dsorensen228/sherman/docs/decisions/README.md

# Architecture Decision Records

Create `NNNN-short-title.md` using the sections: Status, Context, Decision, Alternatives, Consequences, Verification, Rollback, and Links. Status is Proposed, Accepted, Superseded, or Rejected.

An ADR is required for language/runtime changes, safety authority, wire formats, storage engines, OS baselines, display/electrical architecture, exact motor/battery family, chassis envelope freeze, privacy defaults, and any decision that changes multiple owned areas.

Accepted decisions:

- `0001-permanent-luckfox-dev-board.md`
- `0002-expiring-motion-authority.md`
- `0004-zero-touch-charging-and-autonomous-dock.md`
- `0005-dedicated-charge-interlock-pcb.md`
- `0006-generated-idle-banter.md`
- `0007-manual-banter-trigger.md`
- `0008-manual-banter-during-circadian-quiet.md`

Proposed decisions under qualification:

- `0003-landscape-spi-face-display.md`
- `0009-pico-controller-draft.md` — W1 diagnostic firmware and controller protocol;
  physical motion qualification remains open.
