dsorensen228/sherman/assets/concept/PROMPTS.md

# Concept Image Prompts

Generated with the built-in ImageGen path on 2026-08-06. These are product-intent references, not dimensionally accurate designs.

## `sherman-final-product-render.png`

```text
Use case: stylized-concept
Asset type: final product industrial-design hero render for Project Sherman
Primary request: Create a highly polished artistic render of Sherman, a tiny autonomous desktop exploration robot, as a believable finished product.
Scene/backdrop: clean warm-gray industrial design studio sweep, subtle ground plane only.
Subject: a palm-sized robot approximately 70 mm long, 60 mm wide, and 45 mm tall. Rounded pebble-like ivory polycarbonate shell with a charcoal lower chassis. Two small rubber wheels are partially recessed at the left and right rear quarters; a tiny hidden support skid is barely visible. The front face is a glossy black rectangular display window showing two simple expressive cyan-white animated eyes, curious and friendly, no mouth. Below and between the eyes, integrate one very small camera aperture and discreet time-of-flight sensor windows without making it look like a surveillance camera. Include subtle ventilation and a service seam. No arms, antenna, exposed circuit boards, tank treads, logos, or text.
Style/medium: premium photorealistic product visualization with credible injection-molded surfaces and functional compact robotics detailing; cute through proportion and eye expression, not toy-like decoration.
Composition/framing: three-quarter front view at desk level, entire robot visible, generous margin, slight scale cues but no other objects.
Lighting/mood: soft studio key light, delicate rim, grounded shadow, optimistic and quietly capable.
Color palette: warm ivory, graphite, muted teal/cyan eyes, minimal red/orange emergency accent only if needed.
Materials/textures: fine matte shell, satin chassis, realistic rubber tires, anti-reflective glass display.
Constraints: physically plausible compact differential-drive robot; low center of gravity; camera and sensors must not dominate the face; product should feel serviceable and buildable around a development board; no text, no watermark.
Avoid: humanoid body, legs, arms, ears, pet styling, glossy toy plastic, oversized wheels, exposed electronics, impossible floating parts, aggressive military styling, branded marks.
```

## `sherman-desk-context.png`

```text
Use case: stylized-concept
Asset type: Project Sherman desk-context concept art
Primary request: Show the same final Sherman robot concept in use on a real adult work desk, emphasizing tiny scale, autonomy, and personality.
Scene/backdrop: tasteful lived-in home-office desk with keyboard edge, ceramic coffee mug, notebook, monitor stand, and a few cables; everything orderly enough to read clearly.
Subject: Sherman is a palm-sized autonomous differential-drive robot, approximately 70 mm long, 60 mm wide, 45 mm tall. Rounded ivory pebble shell, charcoal lower chassis, two partially recessed rubber wheels, glossy black front display with two simple cyan-white expressive eyes, one tiny camera aperture and discreet time-of-flight windows. He is paused beside the coffee mug, looking up at it with curious slightly narrowed eyes as if investigating a newly moved object. No mouth, arms, antenna, legs, ears, or logos.
Style/medium: cinematic but believable high-end product lifestyle photography / photorealistic industrial design visualization.
Composition/framing: wide three-quarter desk-level view with Sherman fully visible and clearly much smaller than the mug and keyboard; enough negative space to feel like a product story image.
Lighting/mood: warm morning window light, gentle monitor fill, charming and quietly humorous, realistic grounded shadows.
Color palette: warm neutral office, ivory and graphite robot, subtle cyan eye light.
Materials/textures: realistic molded polycarbonate, anti-reflective display glass, rubber wheels, wood or matte laminate desktop.
Constraints: preserve a physically plausible compact wheeled robot design; show no docking station; no text or watermark; camera is subtle and not threatening.
Avoid: toy-scale fake miniature look, humanoid robot, pet costume, oversized eyes protruding from body, exposed electronics, futuristic spaceship desk, clutter hiding the robot, duplicate robot.
```

## Regeneration rules

- Preserve the front black display, ivory shell, graphite lower chassis, two-wheel differential-drive form, tiny sensor apertures, and palm-sized scale.
- Change only one design dimension per iteration and record it here.
- Do not use a render to close mechanical, optical, thermal, or ergonomic requirements.
