dsorensen228/sherman/electronics/prototype-netlist.csv

net | domain | source_endpoint | destination_endpoint | direction | wire | stage | status | notes
LCD_3V3 | 3.3V_LUCKFOX | Luckfox_P1_pin_1 | Waveshare_23822_VCC | power | existing | A | verified | Do not alter
LCD_GND | GND | Luckfox_P1_pin_25 | Waveshare_23822_GND | power | existing | A | verified | Do not alter
LCD_DC | 3.3V_LOGIC | Luckfox_P1_pin_13_GPIO1_D0 | Waveshare_23822_DC | Luckfox_to_LCD | existing | A | verified | gpiochip1_offset_24
LCD_RST_N | 3.3V_LOGIC | Luckfox_P1_pin_15_GPIO1_D1 | Waveshare_23822_RST | Luckfox_to_LCD | existing | A | verified | gpiochip1_offset_25
LCD_MOSI | 3.3V_LOGIC | Luckfox_P1_pin_19_SPI0_M0_MOSI | Waveshare_23822_DIN | Luckfox_to_LCD | existing | A | verified | No_MISO
LCD_CLK | 3.3V_LOGIC | Luckfox_P1_pin_23_SPI0_M0_CLK | Waveshare_23822_CLK | Luckfox_to_LCD | existing | A | verified | Deployed_40MHz
LCD_CS_N | 3.3V_LOGIC | Luckfox_P1_pin_24_SPI0_M0_CS0 | Waveshare_23822_CS | Luckfox_to_LCD | existing | A | verified | Active_low
LCD_BL | 3.3V_LOGIC | Luckfox_P1_pin_26_GPIO1_D2 | Waveshare_23822_BL | Luckfox_to_LCD | existing | A | verified | gpiochip1_offset_26
GND_UART | GND | Luckfox_P1_pin_9_GND | Pico2_pin_3_GND | power | logic | C | proposed | Connect_before_TX_RX
HOST_TX | 3.3V_LOGIC | Luckfox_P1_pin_11_GPIO1_B1_UART4_M0_TX | Pico2_pin_2_GP1_UART0_RX | Luckfox_to_Pico | logic | C | gated | Enable_only_uart4m0_xfer_and_verify_ttyS4_zero_boot_chatter
HOST_RX | 3.3V_LOGIC | Pico2_pin_1_GP0_UART0_TX | Luckfox_P1_pin_7_GPIO1_B0_UART4_M0_RX | Pico_to_Luckfox | logic | C | gated | Enable_only_uart4m0_xfer_and_verify_ttyS4_two_way
FRONT_3V3 | 3.3V_LUCKFOX | Luckfox_P1_pin_17 | Pololu_3417_VIN | power | logic | E | gated | Requires_150mA_measured_Luckfox_rail_headroom_and_never_connect_3417_VDD
FRONT_GND | GND | Luckfox_P1_pin_14 | Pololu_3417_GND | power | logic | E | gated | Front_rail_and_pinmux_gates_apply
FRONT_SCL | 3.3V_LOGIC | Luckfox_P1_pin_3_GPIO1_A0_I2C2_SCL_M0 | Pololu_3417_SCL | bidirectional | logic | E | gated | Open_drain_start_100kHz
FRONT_SDA | 3.3V_LOGIC | Luckfox_P1_pin_5_GPIO1_A1_I2C2_SDA_M0 | Pololu_3417_SDA | bidirectional | logic | E | gated | Default_address_0x29
FRONT_LPN_N | 3.3V_LOGIC | Luckfox_P1_pin_18_GPIO2_A6 | Pololu_3417_LPn | Luckfox_to_sensor | logic | E | gated | Drive_low_or_release_after_gpio2_a6_unclaimed_i2c3m0_inactive_proof
FRONT_INT_N | 3.3V_LOGIC | Pololu_3417_INT | Luckfox_P1_pin_12_GPIO1_C6 | sensor_to_Luckfox | logic | E | gated | Optional_open_drain_sensor_output_verify_pin_unclaimed
FRONT_I2C_RST | 3.3V_LOGIC | Luckfox_P1_pin_16_GPIO2_A7 | Pololu_3417_I2C_RST | Luckfox_to_sensor | logic | E | gated | Active_high_carrier_pulldown_after_gpio2_a7_unclaimed_i2c3m0_inactive_proof
3V3_PICO | 3.3V_PICO | Pico2_pin_36_3V3_OUT | Pololu_3692_left_VIN | power | logic | D | proposed | Bus_logic_equals_VIN
3V3_PICO | 3.3V_PICO | Pico2_pin_36_3V3_OUT | Pololu_3692_right_VIN | power | logic | D | proposed | Bus_logic_equals_VIN
3V3_PICO | 3.3V_PICO | Pico2_pin_36_3V3_OUT | Pololu_2798_VIN | power | logic | D | proposed | Bus_logic_equals_VIN
3V3_PICO | 3.3V_PICO | Pico2_pin_36_3V3_OUT | Adafruit_5580_VIN | power | logic | D | proposed | Gauge_chip_itself_requires_battery
3V3_PICO | 3.3V_PICO | Pico2_pin_36_3V3_OUT | Motor_left_4762_blue_encoder_Vcc | power | logic | F | gated | Encoder_supports_2.7V_to_18V
3V3_PICO | 3.3V_PICO | Pico2_pin_36_3V3_OUT | Motor_right_4762_blue_encoder_Vcc | power | logic | F | gated | Encoder_supports_2.7V_to_18V
GND_LOGIC | GND | Pico2_pin_8_GND | Pololu_3692_left_GND | power | logic | D | proposed | Common_Pico_ground
GND_LOGIC | GND | Pico2_pin_8_GND | Pololu_3692_right_GND | power | logic | D | proposed | Common_Pico_ground
GND_LOGIC | GND | Pico2_pin_8_GND | Pololu_2798_GND | power | logic | D | proposed | Common_Pico_ground
GND_LOGIC | GND | Pico2_pin_8_GND | Adafruit_5580_GND | power | logic | D | proposed | Common_Pico_ground
SAFE_SDA | 3.3V_LOGIC | Pico2_pin_6_GP4_I2C0_SDA | Pololu_3692_left_SDA | bidirectional | logic | D | proposed | Shared_bus
SAFE_SDA | 3.3V_LOGIC | Pico2_pin_6_GP4_I2C0_SDA | Pololu_3692_right_SDA | bidirectional | logic | D | proposed | Shared_bus
SAFE_SDA | 3.3V_LOGIC | Pico2_pin_6_GP4_I2C0_SDA | Pololu_2798_SDA | bidirectional | logic | D | proposed | Shared_bus
SAFE_SDA | 3.3V_LOGIC | Pico2_pin_6_GP4_I2C0_SDA | Adafruit_5580_SDA | bidirectional | logic | D | proposed | Delivered_board_pad_silkscreen_is_SDA
SAFE_SCL | 3.3V_LOGIC | Pico2_pin_7_GP5_I2C0_SCL | Pololu_3692_left_SCL | bidirectional | logic | D | proposed | Open_drain_shared_bus_clock_stretching
SAFE_SCL | 3.3V_LOGIC | Pico2_pin_7_GP5_I2C0_SCL | Pololu_3692_right_SCL | bidirectional | logic | D | proposed | Open_drain_shared_bus_clock_stretching
SAFE_SCL | 3.3V_LOGIC | Pico2_pin_7_GP5_I2C0_SCL | Pololu_2798_SCL | bidirectional | logic | D | proposed | Open_drain_shared_bus_clock_stretching
SAFE_SCL | 3.3V_LOGIC | Pico2_pin_7_GP5_I2C0_SCL | Adafruit_5580_SCL | bidirectional | logic | D | proposed | Open_drain_shared_bus_clock_stretching
CLIFF_L_XSHUT_N | 3.3V_LOGIC | Pico2_pin_24_GP18 | Pololu_3692_left_XSHUT | Pico_to_sensor | logic | D | proposed | Drive_low_or_release_carrier_pullup_means_initial_shared_0x29_window
CLIFF_R_XSHUT_N | 3.3V_LOGIC | Pico2_pin_25_GP19 | Pololu_3692_right_XSHUT | Pico_to_sensor | logic | D | proposed | Drive_low_or_release_carrier_pullup_means_initial_shared_0x29_window
CLIFF_L_INT_N | 3.3V_LOGIC | Pololu_3692_left_GPIO1 | Pico2_pin_26_GP20 | sensor_to_Pico | logic | D | proposed | Open_drain_at_2.8V
CLIFF_R_INT_N | 3.3V_LOGIC | Pololu_3692_right_GPIO1 | Pico2_pin_27_GP21 | sensor_to_Pico | logic | D | proposed | Open_drain_at_2.8V
IMU_INT1 | 3.3V_LOGIC | Pololu_2798_INT1 | Pico2_pin_29_GP22 | sensor_to_Pico | logic | D | proposed
IMU_INT2 | 3.3V_LOGIC | Pololu_2798_INT2_DEN | Pico2_pin_31_GP26 | sensor_to_Pico | logic | D | proposed
GND_DRIVER_LOGIC | GND | Pico2_pin_13_GND | Pololu_2130_GND | power | logic | F | gated | Common_at_driver_star
MOTOR_L_IN1 | 3.3V_LOGIC | Pico2_pin_11_GP8_PWM4_A | Pololu_2130_AIN1 | Pico_to_driver | logic | F | gated | Add_10k_pulldown_at_driver
MOTOR_L_IN2 | 3.3V_LOGIC | Pico2_pin_12_GP9_PWM4_B | Pololu_2130_AIN2 | Pico_to_driver | logic | F | gated | Add_10k_pulldown_at_driver
MOTOR_R_IN1 | 3.3V_LOGIC | Pico2_pin_14_GP10_PWM5_A | Pololu_2130_BIN1 | Pico_to_driver | logic | F | gated | Add_10k_pulldown_at_driver
MOTOR_R_IN2 | 3.3V_LOGIC | Pico2_pin_15_GP11_PWM5_B | Pololu_2130_BIN2 | Pico_to_driver | logic | F | gated | Add_10k_pulldown_at_driver
MOTOR_RAIL_REQUEST | 3.3V_LOGIC | Pico2_pin_5_GP3 | Interlock_PCB_J1_3_GP3 | pico_to_interlock | logic | F | gated | PCB_R4_10k_pulldown_default_low
MOTOR_SLEEP_REQUEST | 3.3V_LOGIC | Pico2_pin_16_GP12 | Interlock_PCB_J1_4_GP12 | pico_to_interlock | logic | F | gated | PCB_R6_10k_pulldown_default_low
MOTOR_GATE_CTRL | 3.3V_LOGIC | Interlock_PCB_J3_1_RAIL | Pololu_2808_M_CTRL | interlock_to_power_gate | logic | F | gated | AND_of_motor_rail_request_and_charge_absent
MOTOR_GATE_CTRL | 3.3V_LOGIC | Interlock_PCB_R5_10k | Interlock_PCB_J3_3_GND | internal_pcb | pcb | F | gated | Onboard_output_pulldown_do_not_duplicate_at_2808
MOTOR_SLEEP_N | 3.3V_LOGIC | Interlock_PCB_J3_2_SLEEP | Pololu_2130_nSLEEP_SLP | interlock_to_driver | logic | F | gated | AND_of_motor_sleep_request_and_charge_absent
MOTOR_SLEEP_N | 3.3V_LOGIC | Interlock_PCB_R7_4.7k | Interlock_PCB_J3_3_GND | internal_pcb | pcb | F | gated | Onboard_fail_safe_pulldown_do_not_duplicate_at_driver
INTERLOCK_GND | GND | Pico2_pin_23_GND | Interlock_PCB_J1_2_GND | power | logic | F | gated | Dedicated_Pico_harness_ground
INTERLOCK_GND | GND | Adafruit_4755_GND | Interlock_PCB_J2_3_GND | power | logic | F | gated | Charger_signal_harness_ground
INTERLOCK_GND | GND | Interlock_PCB_J3_3_GND | Driver_power_gate_ground_star | power | logic | F | gated | Output_harness_ground
MOTOR_FAULT_N | 3.3V_LOGIC | Pololu_2130_nFAULT | Pico2_pin_17_GP13 | driver_to_Pico | logic | F | gated | Defer_10k_pullup_to_powered_Stage11_and_require_no_backpower_gate
GND_ENCODER | GND | Pico2_pin_18_GND | Motor_left_4762_green_encoder_GND | power | logic | F | gated
GND_ENCODER | GND | Pico2_pin_18_GND | Motor_right_4762_green_encoder_GND | power | logic | F | gated
ENC_L_A | 3.3V_LOGIC | Motor_left_4762_yellow_channel_A | Pico2_pin_19_GP14 | motor_to_Pico | logic | F | gated | Encoder_has_10k_pullup_to_Vcc
ENC_L_B | 3.3V_LOGIC | Motor_left_4762_white_channel_B | Pico2_pin_20_GP15 | motor_to_Pico | logic | F | gated | Encoder_has_10k_pullup_to_Vcc
ENC_R_A | 3.3V_LOGIC | Motor_right_4762_yellow_channel_A | Pico2_pin_21_GP16 | motor_to_Pico | logic | F | gated | Encoder_has_10k_pullup_to_Vcc
ENC_R_B | 3.3V_LOGIC | Motor_right_4762_white_channel_B | Pico2_pin_22_GP17 | motor_to_Pico | logic | F | gated | Encoder_has_10k_pullup_to_Vcc
MOTOR_L_OUT1 | MOTOR_SWITCHED | Pololu_2130_AOUT1 | Motor_left_4762_red_M1 | driver_to_motor | 22AWG_extension_to_28AWG_Pololu_4762 | F | gated | Use_unmodified_short_4762_and_qualify_drop_temperature_wheels_off
MOTOR_L_OUT2 | MOTOR_SWITCHED | Pololu_2130_AOUT2 | Motor_left_4762_black_M2 | driver_to_motor | 22AWG_extension_to_28AWG_Pololu_4762 | F | gated | Use_unmodified_short_4762_and_qualify_drop_temperature_wheels_off
MOTOR_R_OUT1 | MOTOR_SWITCHED | Pololu_2130_BOUT1 | Motor_right_4762_red_M1 | driver_to_motor | 22AWG_extension_to_28AWG_Pololu_4762 | F | gated | Use_unmodified_short_4762_and_qualify_drop_temperature_wheels_off
MOTOR_R_OUT2 | MOTOR_SWITCHED | Pololu_2130_BOUT2 | Motor_right_4762_black_M2 | driver_to_motor | 22AWG_extension_to_28AWG_Pololu_4762 | F | gated | Use_unmodified_short_4762_and_qualify_drop_temperature_wheels_off
CHARGE_IN_5V | 5V_CHARGE | Exterior_USB_C_5V | Adafruit_4755_USB_C_input | power | external_USB_C | G | gated | Only_normal_V1_user_action_is_insert_powered_cable
DOCK_5V_RAW | 5V_DOCK | Dock_5V_supply_positive | Dock_default_off_power_switch_input | power | 22AWG | G | gated | Dock_controller_defaults_output_off
DOCK_5V | 5V_DOCK | Dock_default_off_power_switch_output | Adafruit_4755_DC_barrel_center_positive | power | recessed_asymmetric_power_contact | G | gated | Energize_only_after_stable_pilot_proof
DOCK_GND | GND | Dock_5V_supply_negative | Adafruit_4755_DC_barrel_sleeve_GND | power | recessed_ground_contact | G | gated | Ground_first_mate_last_break
DOCK_PILOT | low_energy_dock_logic | Dock_current_limited_pilot | Robot_identity_and_presence_network | bidirectional | pilot_contact | G | gated | Proves_alignment_before_dock_5V_enable
DOCK_RELEASE_N | low_energy_dock_logic | Robot_open_drain_release_request | Dock_controller_input | robot_to_dock | release_contact | G | gated | Low_requests_5V_removal_before_autonomous_departure
CHARGE_ABSENT | 3.3V_LOGIC | Interlock_PCB_J1_5_CA | Pico2_pin_9_GP6_CHARGE_ABSENT_observer | interlock_to_Pico | logic | F | gated | Input_only_observer_firmware_must_never_drive
CHARGE_ABSENT | 3.3V_LOGIC | Adafruit_4755_PGOOD | Interlock_PCB_J2_2_PGOOD | open_drain | logic | F | gated | Valid_charge_input_forces_PCB_CHARGE_ABSENT_low
CHARGE_ABSENT | 3.3V_LOGIC | Interlock_PCB_Q1_2N3904BU_collector | Interlock_PCB_CHARGE_ABSENT_node | open_collector | pcb | F | gated | Raw_VBUS_presence_forces_low_immediately_PCB_R1_is_10k_pullup
CHARGE_VBUS_SENSE | 5V_CHARGE | Adafruit_4755_VBUS | Interlock_PCB_J2_1_VBUS | charge_to_interlock | logic | F | gated | PCB_R2_47k_to_Q1_base_R3_100k_base_emitter_pulldown
3V3_PICO | 3.3V_PICO | Pico2_pin_36_3V3_OUT | Interlock_PCB_J1_1_3V3 | power | logic | F | gated | Feeds_U1_pin14_and_C1_100nF_on_PCB
INTERLOCK_GND | GND | Interlock_PCB_J1_2_GND | Interlock_PCB_U1_pin7_and_unused_inputs | internal_pcb | pcb | F | gated | Unused_gate_inputs_tied_GND_outputs_open
CHARGE_ISET | control | Adafruit_4755_factory_1A_jumper | Open_cut_trace | passive | board_configuration | G | gated | Must_be_open_before_Adafruit_258_is_connected
CHARGE_ISET | control | Adafruit_4755_0.5A_jumper | Closed_solder_bridge | passive | board_configuration | G | gated | Only_allowed_charge_setting_for_Adafruit_258
VBAT_RAW | 3.0V_to_4.23V | Adafruit_258_JST_positive | Selected_battery_fuse_input | power | factory_cell_lead_to_keyed_22AWG_harness | G | gated | Fuse_physically_close_to_cell_no_positive_branch_before_fuse
VBAT_GND | GND | Adafruit_258_JST_negative | Protected_battery_ground_star | power | factory_cell_lead_to_keyed_22AWG_harness | G | gated | Cell_stays_installed_for_normal_dock_charging
VBAT_FUSED | 3.0V_to_4.23V | Selected_battery_fuse_output | Adafruit_4755_BATT_LIPO_positive | power | verified_polarity_22AWG | G | gated | Bidirectional_fuse_path_must_pass_discharge_and_500mA_charge
VBAT_FUSED | 3.0V_to_4.23V | Selected_battery_fuse_output | Adafruit_5580_BAT_JST_positive | power | verified_polarity_JST | G | gated | Gauge_senses_battery_not_charger_OUT_no_system_current_through_5580
VBAT_FUSED | 3.0V_to_4.23V | Selected_battery_fuse_output | Pololu_2808_M_VIN | power | 22AWG | G | gated | Separate_motor_branch_never_passes_through_4755_LOAD_OUT
VBAT_GND | GND | Protected_battery_ground_star | Adafruit_4755_GND | power | 22AWG | G | gated | Common_charger_battery_and_load_return
VBAT_GND | GND | Protected_battery_ground_star | Adafruit_5580_BAT_JST_negative | power | verified_polarity_JST | G | gated | Gauge_ground_branch_no_system_current_through_5580
VBAT_GND | GND | Protected_battery_ground_star | Pololu_2808_M_GND | power | 22AWG | G | gated | Automatic_motor_gate_return
LOAD_RAW | 3.0V_to_4.4V | Adafruit_4755_LOAD_OUT_positive | Selected_system_fuse_input | power | 22AWG | G | gated | Compute_only_envelope_must_remain_below_1.5A
LOAD_FUSED | 3.0V_to_4.4V | Selected_system_fuse_output | Pololu_2808_S_VIN | power | 22AWG | G | gated | System_fuse_physically_close_to_4755_OUT
GND_POWER | GND | Adafruit_4755_GND | Pololu_2808_S_GND | power | 22AWG | G | gated | Common_compute_power_path_return
SYS_SW | 3.0V_to_4.4V | Pololu_2808_S_VOUT | Pololu_2891_VIN | power | 22AWG | G | gated | Compute_power_gate_required
GND_POWER | GND | Pololu_2808_S_GND | Pololu_2891_GND | power | 22AWG | G | gated | Compute_power_gate_return
MOTOR_VIN | 0V_inhibited_or_3.0V_to_4.23V_armed | Pololu_2808_M_VOUT | Pololu_2130_VIN | power | 22AWG | G | gated | Automatic_gate_low_on_charge_reset_or_missing_logic
GND_POWER | GND | Pololu_2808_M_GND | Pololu_2130_GND | power | 22AWG | G | gated | Ground_star_near_driver
5V_SYS | 5V | Pololu_2891_VOUT | Luckfox_P1_pin_2_5V | power | 22AWG | G | gated | Parallel_equal_lead_with_P1_pin_4_and_never_with_USB_power
5V_SYS | 5V | Pololu_2891_VOUT | Luckfox_P1_pin_4_5V | power | 22AWG | G | gated | Parallel_equal_lead_with_P1_pin_2_and_never_with_USB_power
5V_SYS | 5V | Pololu_2891_VOUT | Pico2_pin_39_VSYS | power | 22AWG | G | gated | Never_with_Pico_USB_in_W1
GND_POWER | GND | Pololu_2891_GND | Luckfox_P1_pin_6_GND | power | 22AWG | G | gated | Parallel_return_with_P1_pin_20
GND_POWER | GND | Pololu_2891_GND | Luckfox_P1_pin_20_GND | power | 22AWG | G | gated | Parallel_return_with_P1_pin_6
GND_POWER | GND | Pololu_2891_GND | Pico2_pin_38_GND | power | 22AWG | G | gated | Final_power_harness
POWER_BUTTON | control | Pololu_2808_S_A | Momentary_NO_switch_contact_1 | passive | logic | G | gated | System_power_button_not_a_charge_step
POWER_BUTTON | control | Pololu_2808_S_B | Momentary_NO_switch_contact_2 | passive | logic | G | gated | System_power_button_not_a_charge_step
