dsorensen228/sherman/docs/hardware/shopping-list.csv

gate | subsystem | manufacturer | part | sku | quantity | unit_price_usd | extended_usd | status | url | notes
ORDERED-2026-08-07 | compute | Luckfox | Luckfox Pico Ultra W 256MB wireless | Ultra W option | 1 | 50.99 | 50.99 | ordered receiving pending | https://www.luckfox.com/EN-Luckfox-Pico-Ultra?ci=510 | Do not order 4-inch LCD or PoE kit
ORDERED-2026-08-07 | face | Waveshare | 1.9inch LCD Module 170x320 ST7789V2 | 23822 | 2 | 11.99 | 23.98 | ordered receiving pending | https://www.waveshare.com/1.9inch-lcd-module.htm | One target plus identical bench spare; cable included
ORDERED-2026-08-07 | camera | Luckfox | SC3336 3MP Camera B with FFC | 25553 | 1 | 8.99 | 8.99 | ordered receiving pending | https://www.luckfox.com/EN-SC3336-3MP-Camera-B | Vendor-supported Ultra camera
ORDERED-2026-08-14 | front ranging | Pololu | VL53L5CX carrier | 3417 | 1 | 19.95 | 19.95 | ordered receiving pending | https://www.pololu.com/product/3417 | 8x8 multizone front sensor
ORDERED-2026-08-14 | safety controller | Raspberry Pi | Raspberry Pi Pico 2 non-wireless no headers | Pico 2 | 1 | 5.00 | 5.00 | ordered receiving pending | https://www.raspberrypi.com/products/raspberry-pi-pico-2/ | Low-profile robot controller
ORDERED-2026-08-14 | safety controller | Raspberry Pi | Raspberry Pi Pico 2 non-wireless with headers | Pico 2 with headers | 1 | 6.00 | 6.00 | ordered receiving pending | https://www.raspberrypi.com/products/raspberry-pi-pico-2/ | Breadboard and HIL peer
RECEIVED-2026-08-30 | cliff sensing | Pololu | VL53L4CD carrier | 3692 | 3 | 13.95 | 41.85 | two wired plus one spare | https://www.pololu.com/product/3692 | Two installed through passive I2C hub; XSHUT startup still must be qualified
RECEIVED-2026-08-30 | IMU | Pololu | LSM6DSO carrier | 2798 | 1 | 19.95 | 19.95 | wired | https://www.pololu.com/product/2798 | Installed through passive I2C hub; record mounted orientation
ORDERED-2026-08-14 | motors | Pololu | 298:1 Micro Metal Gearmotor MP 6V encoder back connector | 5146 | 3 | 29.95 | 89.85 | ordered receiving pending | https://www.pololu.com/product/5146 | Matched pair plus spare
ORDERED-2026-08-14 | motor harness | Pololu | 6-pin encoder cable 12cm female to unterminated | 4762 | 3 | 2.10 | 6.30 | ordered receiving pending | https://www.pololu.com/product/4762 | One per motor
ORDERED-2026-08-14 | wheels | Pololu | Black Wheel 32x7mm Pair | 1087 | 2 | 4.45 | 8.90 | ordered receiving pending | https://www.pololu.com/product/1087 | One pair plus spare pair
ORDERED-2026-08-14 | motor mounts | Pololu | Black Micro Metal Gearmotor Bracket Pair | 989 | 2 | 2.95 | 5.90 | ordered receiving pending | https://www.pololu.com/product/989 | One pair plus spare pair
ORDERED-2026-08-14 | motor driver | Pololu | DRV8833 Dual Motor Driver Carrier | 2130 | 2 | 10.95 | 21.90 | ordered receiving pending | https://www.pololu.com/product/2130 | One installed plus bench spare
ORDERED-2026-08-14 | 5V rail | Pololu | 5V Step-Up Regulator U3V70F5 | 2891 | 2 | 22.95 | 45.90 | ordered receiving pending | https://www.pololu.com/product/2891 | Qualification gate remains: measure efficiency ripple transient and heat
ORDERED-2026-08-14 | power gating | Pololu | Mini Pushbutton Power Switch LV | 2808 | 2 | 4.95 | 9.90 | ordered receiving pending | https://www.pololu.com/product/2808 | One system switch and one automatic motor-rail gate; qualify CTRL override and current/thermal behavior; not an emergency disconnect
ORDERED-2026-08-14 | battery | Adafruit | Protected 3.7V 1200mAh LiPo | 258 | 2 | 9.95 | 19.90 | ordered receiving pending | https://www.adafruit.com/product/258 | Qualification gate remains; 34x62x5mm 23g and 2A cable constraint
ORDERED-2026-08-14 | charger | Adafruit | USB-C Micro-Lipo Charger | 4410 | 1 | 5.95 | 5.95 | ordered receiving pending | https://www.adafruit.com/product/4410 | Retained for standalone cell bench work only; not installed in Sherman
RECEIVED-2026-08-30+ORDERED-2026-09-01 | power-path charger | Adafruit | Universal USB/DC/Solar LiPo charger (BQ24074) | 4755 | 3 | 14.95 | 44.85 | one received plus two incoming; qualification pending | https://www.digikey.com/en/products/detail/adafruit-industries-llc/4755/12968352 | Exterior USB-C and LOAD sharing for responsive compute only; retain one qualified spare and reserve the third for bench/fault work; replace hardware if 1.5A OUT limit fails
RECEIVED-2026-08-30 | I2C distribution | GODIYMODULES | I2C Interface Expansion Module I2Chub I2Cadapter Board | B0DGQBFSKL | 1 | 11.99 | 11.99 | installed with IMU and two cliff sensors | https://www.amazon.com/dp/B0DGQBFSKL | Passive 10-port 3.3V I2C distribution only; not a multiplexer and does not resolve duplicate addresses
ORDERED-2026-08-14 | fuel gauge | Adafruit | MAX17048 Battery Monitor | 5580 | 1 | 5.95 | 5.95 | ordered receiving pending | https://www.adafruit.com/product/5580 | Qualification gate remains; validate SOC under pulsed motor load
