dsorensen228/sherman/cad/enclosure/Sherman.stl

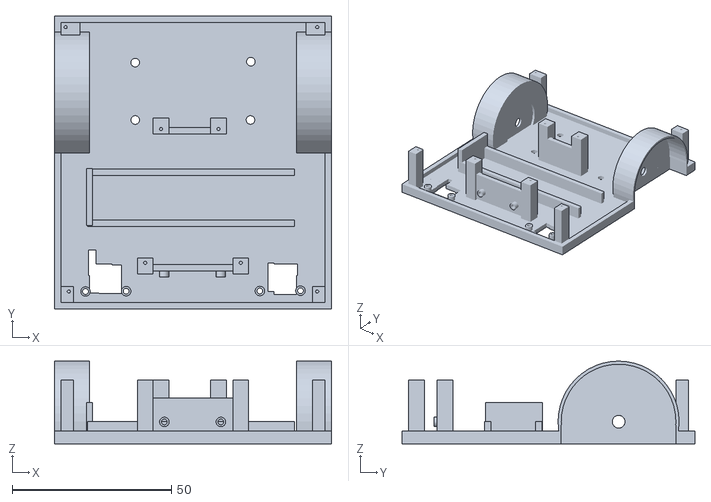
[picture p1: CAD file, 2026-10-16]
cad/enclosure/Sherman.stl
87.0 x 92.0 x 26.0
