dsorensen228/sherman/models/components/step/adafruit-5580-max17048.step

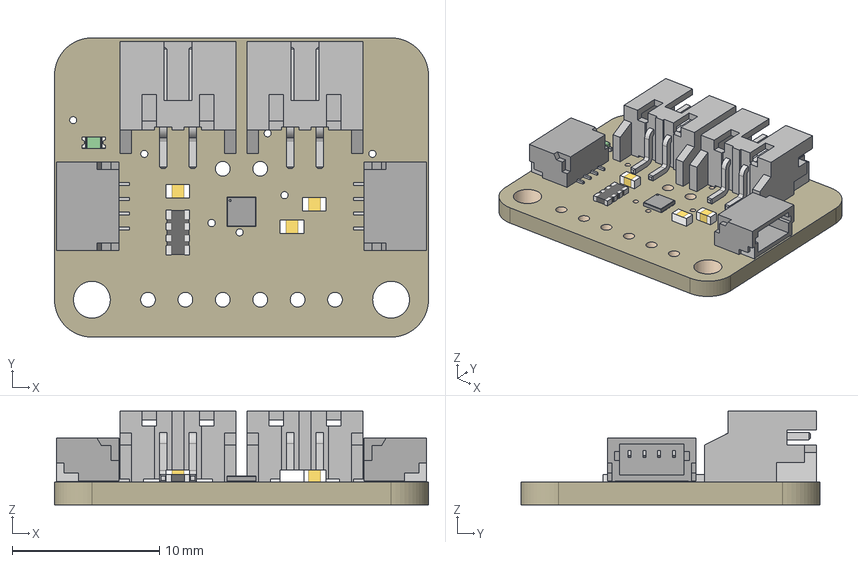
[picture p2: CAD file, 2026-10-16]
models/components/step/adafruit-5580-max17048.step
25.4 x 20.3 x 6.37 mm
Board
1uF x 3
10K
STEMMA_I2C_QT x 2
GREEN
JST 2 PH x 2
MAX17048/T
