dsorensen228/sherman/models/components/stl/luckfox-pico-ultra-w-envelope.stl

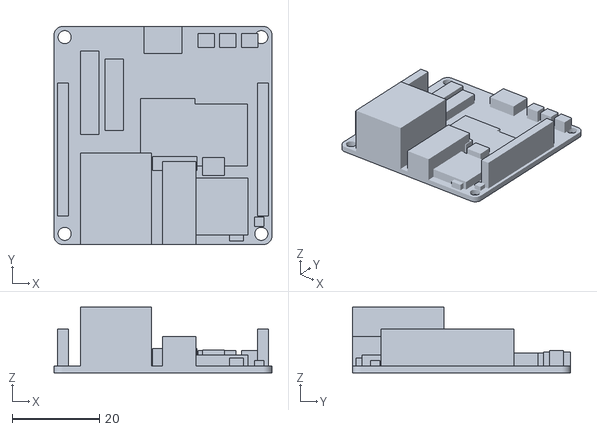
[picture p3: CAD file, 2026-10-16]
models/components/stl/luckfox-pico-ultra-w-envelope.stl
50.0 x 50.0 x 15.1
