dsorensen228/sherman/cad/enclosure/Base.stl

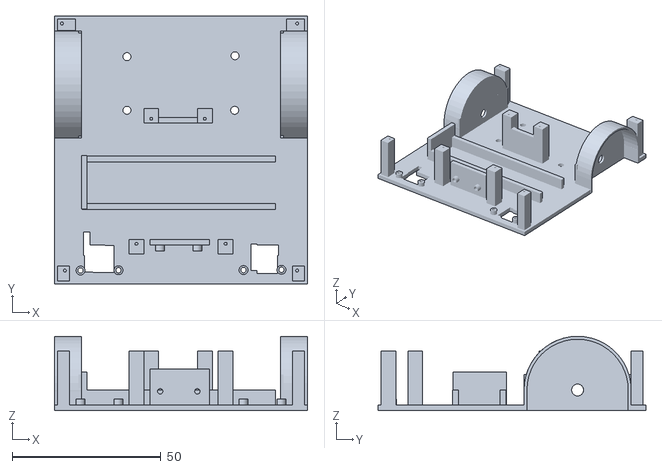
[picture p4: CAD file, 2026-10-16]
cad/enclosure/Base.stl
85.0 x 90.0 x 25.0
