dsorensen228/sherman/models/components/step/raspberry-pi-pico-2.step

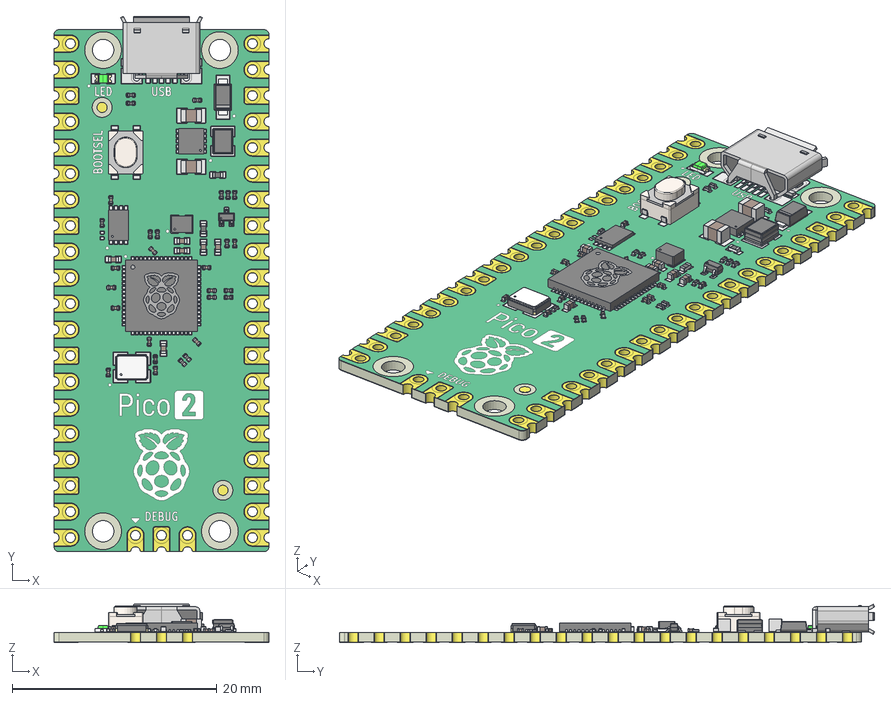
[picture p5: CAD file, 2026-10-16]
models/components/step/raspberry-pi-pico-2.step
21.0 x 52.3 x 3.77 mm
CapacitorMainBody x 21
CapacitorContacts x 21
ResistorMainBody x 17
ResistorBlackLayer x 17
ResistorContacts x 17
Pins x 7
Package x 5
EP x 3
Pin1Indicator x 5
Logo
Chassis
Contacts x 3
Back
CathodeIndicator
Lid
Pads
PinIndicator
White_Body
Lens
Plastic_Body
Metal_Plate
Plastic_Plunger
rpi_pico2_PCB
