dsorensen228/sherman/models/components/stl/pololu-4762-encoder-cable-envelope.stl

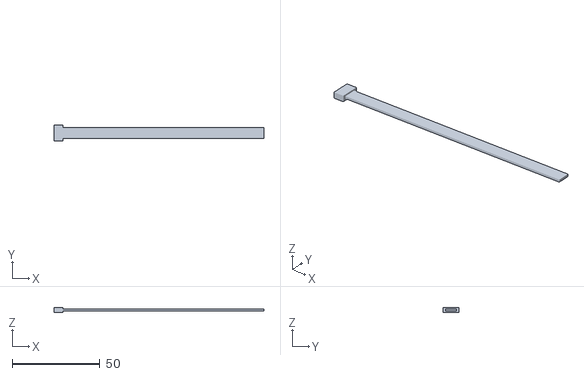
[picture p6: CAD file, 2026-10-16]
models/components/stl/pololu-4762-encoder-cable-envelope.stl
120.0 x 9.00 x 2.90
