dsorensen228/sherman/models/components/stl/sc3336-camera-b-envelope.stl

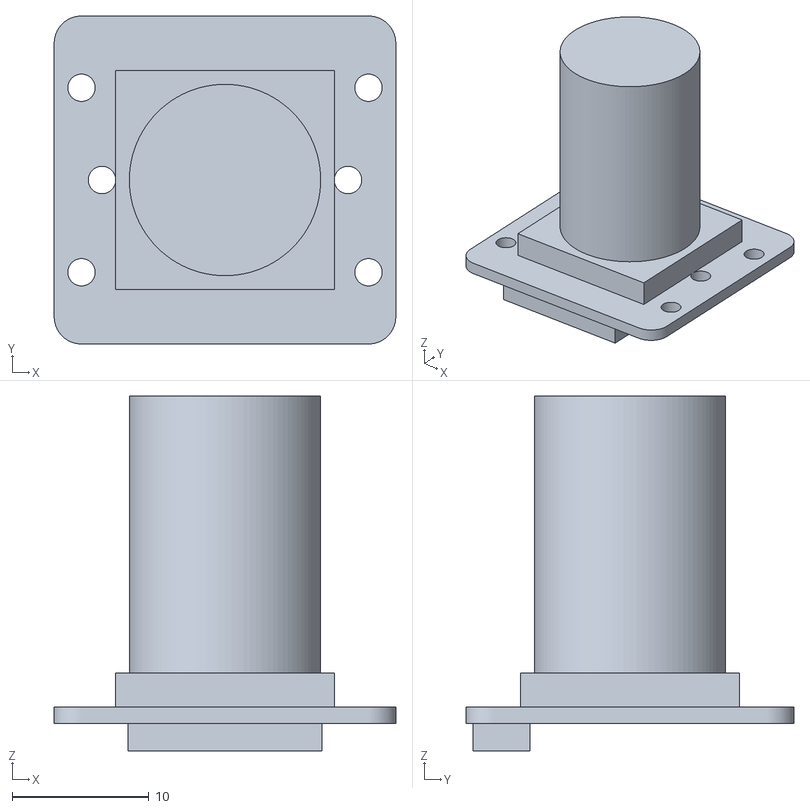
[picture p8: CAD file, 2026-10-16]
models/components/stl/sc3336-camera-b-envelope.stl
25.0 x 24.0 x 25.9
