dsorensen228/sherman/firmware/linux/luckfox-ultra-w/luckfox.cfg

SPI0_M0_CS_ENABLE=1
SPI0_M0_MODE=1
RGB_ENABLE=0
SPI0_M0_STATUS=1
SPI0_M0_MISO_ENABLE=0
SPI0_M0_SPEED=40000000
UART4_M0_STATUS=1
I2C2_M0_STATUS=1
I2C2_M0_SPEED=100000
